FeelinPeachyMate/PCB_watch_Online/PCBwayReview.docx

# Pcbway – Sponsership

First, I want to thank PCBway, and personally Liam from the marketing team for reaching out and offering this opportunity! Thank you so much. Also thank you for being patient with me as it took quite some time to arrange everything, especially due to my internship and university stuff.

If you are looking for a friendly and good place to order your PCB’s I would advice PCBway.

# Ordering process & Service

The ordering process went smoothly and showed alot more options than the pervious place I had ordered which was not only fun but also very useful!

From various surface finishes to fit to your exact needs, to many fun different PCB colours!

Every option is also supported with a green questionmark which contains all the explanation a beginner could need to understand.

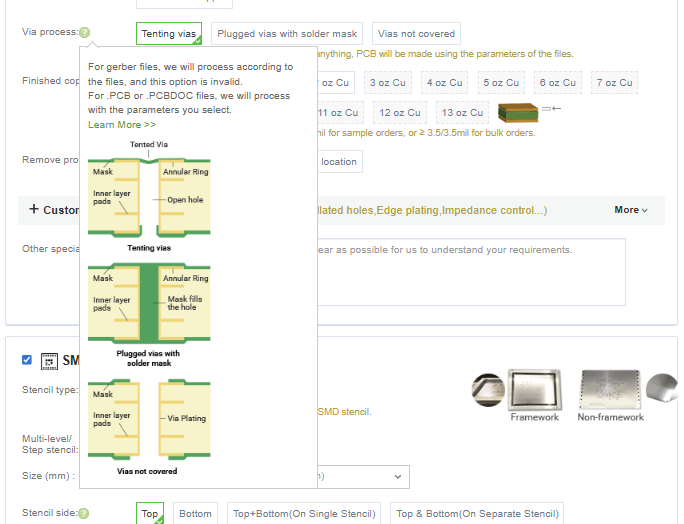
[picture p1: figure]

Figure 1 Example explanation

During the development process the team made sure to reach out to confirm various things, they pay great attention to details and ensure that the client will be happy with the final result. From more complex confirms such as polarity to lower priorities such as silkscreen designs.

Upon discovering certain things, they accept a corrected file and continue onwards.

During Chinese new year they made sure to update the customer on the state of the PCB delivery and wished a happy new year.

Once finished the PCB’s arrived fairly quick.

# First impression

The PCB’s arrived in static free bags ready to use, no need to click them out of any frame or anything, giving them a nice rounded clean ridge.

The silk screen looked very nice and even could handle small details like very tiny a kaomoji. The gold finish looked very neat.

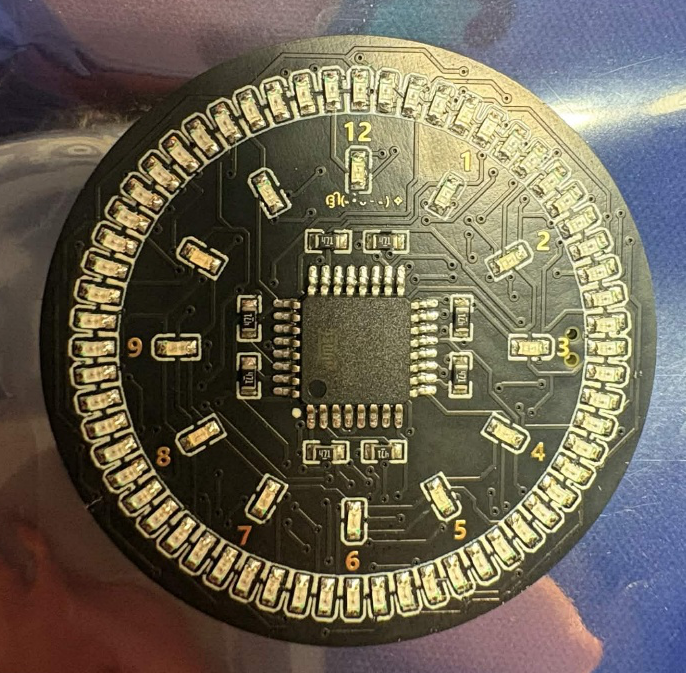
[picture p2: figure]

Overall, the components were attached sturdy, as I could use the button as leverage to pull the PCB out the watch case.

Programming using the programming pads was also a pleasant surprise, as the previous one had gotten scratched up and dented from the pogo pins I had used, but the PCB from PCBway showed no such damage, as can be seen down below.

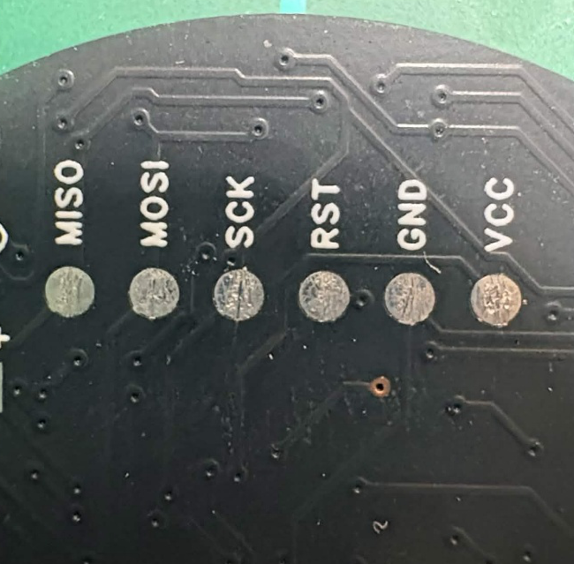
[picture p3: figure]
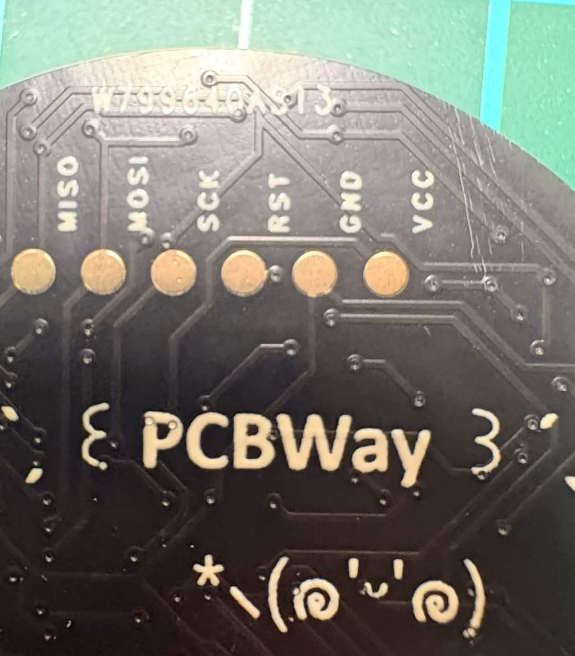
[picture p4: figure]

# Usage

My first prototype was produced by a different PCB company, which will not be stated. This PCB was alright, but as the soldering pads broke off multiple times during production it did show some lack of quality. Recently the one that was gifted to a dear one, also had a pad break off the PCB, I got to first hand try the new ones delivered by the PCBway sponsorship!

First I want to mention how easy it is to get solder on the pads, which is very pleasant. Especially for beginners.

Also, as I had made a small mistake in the orientation of a component ( my mistake truly I sent the wrong version ) I had to fix the orientation of an 8 pin chip. This task was deemed surprisingly easy and I was able to complete it on all the models I received within an hour, I believe this also speaks for the quality, and the ease for beginners aswell. As it is not hard to correct your own mistakes! 😊

# Conclusion

Here you can see the PCB back in its case, fully working! Overall I would highly recommend PCBway and would definitely order my future custom PCB’s at them! They deliver quality, the staff is kind and precise, and the price to quality ratio is good!

Once again thank you so much and if you are ordering yours: Order custom PCB's here! (https://www.pcbway.com/)

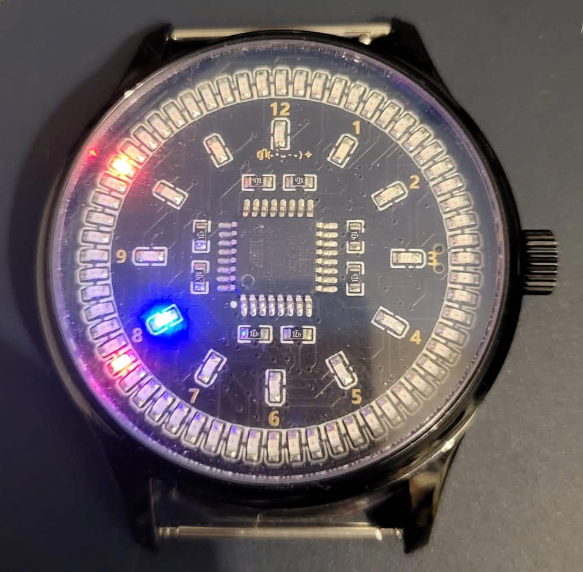
[picture p5: figure]
