FeelinPeachyMate/PCB_watch_Online/PCB_Watch_Files/BOM__Schematic1_PCB1_2025-12-17.xlsx

No. | Quantity | Comment | Designator | Footprint | Value | Manufacturer Part | Manufacturer | Supplier Part | Supplier
1 | 2 | Test-Point | B+,B- | Test-Point-0.5mm
2 | 2 | 100nF | C1,C5 | C0603 | 100nF | CC0603KRX7R9BB104 | YAGEO(国巨) | C14663 | LCSC
3 | 1 | 20pF | C2 | C0603 | 20pF | CL10C200JB8NNNC | SAMSUNG(三星) | C1648 | LCSC
4 | 1 | 10uF | C3 | C0603 | 10uF | CL10A106KP8NNNC | SAMSUNG(三星) | C19702 | LCSC
5 | 1 | 1uF | C4 | C0603 | 1uF | CL10A105KB8NNNC | SAMSUNG(三星) | C15849 | LCSC
6 | 6 | Test-Point1 | GND,MISO,MOSI,RST,SCK,VCC | Test-Point-0.5mm1
7 | 60 | XL-1608SURC-06 | LED1,LED2,LED3,LED4,LED5,LED6,LED7,LED8,LED9,LED10,LED11,LED12,LED13,LED14,LED15,LED16,LED17,LED18,LED19,LED20,LED21,LED22,LED23,LED24,LED25,LED26,LED27,LED28,LED29,LED30,LED31,LED32,LED33,LED34,LED35,LED36,LED37,LED38,LED39,LED40,LED41,LED42,LED43,LED44,LED45,LED46,LED47,LED48,LED49,LED50,LED51,LED52,LED53,LED54,LED55,LED56,LED57,LED58,LED59,LED60 | LED0603-RD_RED |  | XL-1608SURC-06 | XINGLIGHT(成兴光) | C965799 | LCSC
8 | 12 | XL-1608UBC-04 | LED61,LED62,LED63,LED64,LED65,LED66,LED67,LED68,LED69,LED70,LED71,LED72 | LED0603-RD_BLUE |  | XL-1608UBC-04 | XINGLIGHT(成兴光) | C965807 | LCSC
9 | 10 | 470Ω | R1,R2,R3,R4,R5,R6,R7,R8,R9,R10 | R0603 | 470Ω | 0603WAF4700T5E | UNI-ROYAL(厚声) | C23179 | LCSC
10 | 2 | 4.7kΩ | R11,R12 | R0603 | 4.7kΩ | 0603WAF4701T5E | UNI-ROYAL(厚声) | C23162 | LCSC
11 | 1 | TS24CA 250gf 013 | SW1 | SW-SMD_L4.7-W3.5-P3.35-EH |  | TS24CA 250gf 013 | SHOU HAN(首韩) | C5373430 | LCSC
12 | 1 | ATMEGA328P-AU | U1 | TQFP-32_L7.0-W7.0-P0.80-LS9.0-BL |  | ATMEGA328P-AU | MICROCHIP(美国微芯) | C14877 | LCSC
13 | 1 | DS3231MZ+TRL | U2 | SOIC-8_L4.9-W3.9-P1.27-LS6.0-BL |  | DS3231MZ+TRL | ADI(亚德诺)/MAXIM(美信) | C107410 | LCSC
14 | 1 | 16MHz | X1 | OSC-SMD_2P-L5.0-W3.2 | 16MHz | XSHEELNANF-16MHZ | TAITIEN(泰艺电子) | C242221 | LCSC
